f1egmatik/aircontrol/kicad/aircontrol.sch

## KiCad design kicad/aircontrol.sch (2021-11-26)

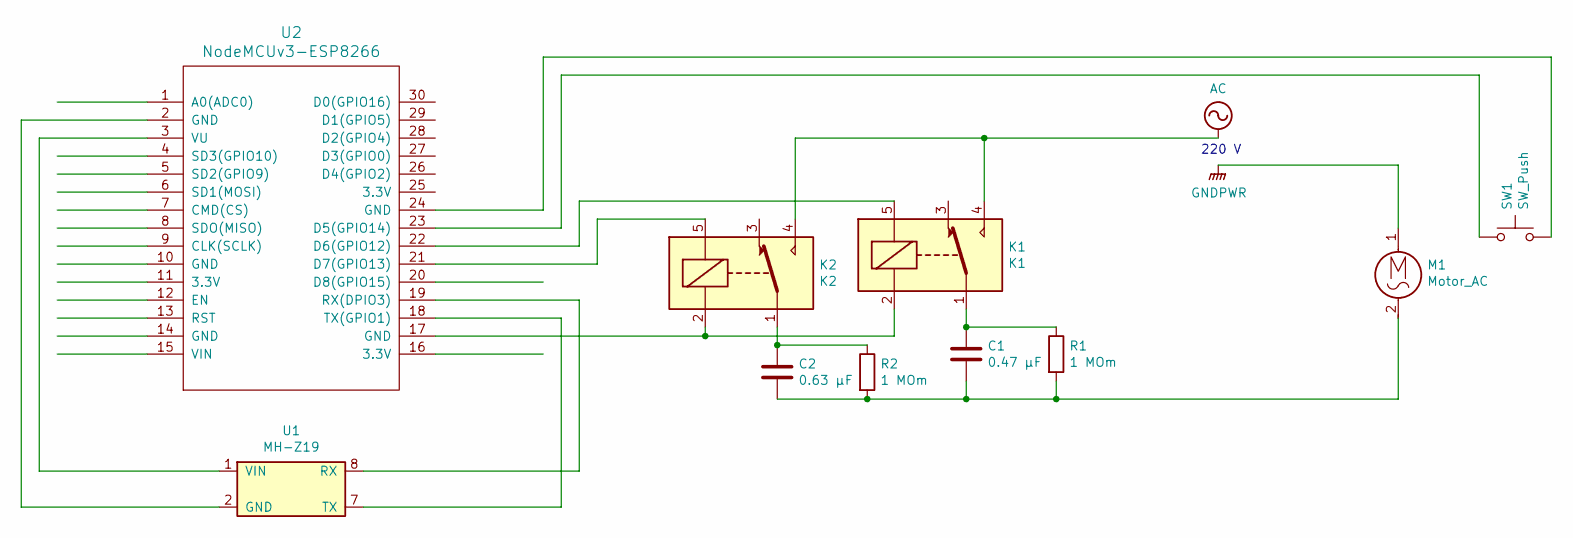
[picture p2: schematic aircontrol.sch]

Parts:
C1: 0.47 μF
C2: 0.63 μF
K1: K1; Relay_SPDT_SANYOU_SRD_Series_Form_C
K2: K2; Relay_SPDT_SANYOU_SRD_Series_Form_C
M1: Motor_AC
R1, R2: 1 MOm
SW1: SW_Push
U1: MH-Z19
U2: NodeMCUv3-ESP8266

Connections:
AC: K1.4, K2.4
GNDPWR: M1.1
unnamed: C1.1, K1.1, R1.1
unnamed: C1.2, C2.2, M1.2, R1.2, R2.2
unnamed: C2.1, K2.1, R2.1
unnamed: K1.2, K2.2, U2.17 (GND)
unnamed: K1.5, U2.22 (D6(GPIO12))
unnamed: K2.5, U2.21 (D7(GPIO13))
unnamed: SW1.1, U2.23 (D5(GPIO14))
unnamed: SW1.2, U2.24 (GND)
unnamed: U1.1 (VIN), U2.3 (VU)
unnamed: U1.2 (GND), U2.2 (GND)
unnamed: U1.7 (TX), U2.18 (TX(GPIO1))
unnamed: U1.8 (RX), U2.19 (RX(DPIO3))

Notes on the sheet:
220 V
