f1egmatik/aircontrol/(commit log)

2021-03-11 Update aircontrol.yaml
    Перенос кода из форка.
2021-03-11 Update dht_am2302.yaml
    Добавлена переменная `source_sensor_id`
2021-03-11 Update mhz19.yaml
    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
2021-03-13 Update aircontrol.yaml
    Инвертирована логика работы переключателя автоматического режима, добавлено авто включение при загрузке, а так же изменен его ID. Правка комментариев.
2021-03-13 Update aircontrol.yaml
    Исправлена ошибка логики.
    [aircontrol.yaml]
2021-03-13 Update dht_am2302.yaml
    Вход кнопки изменен на D6
2021-03-13 Update mhz19.yaml
    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
2021-03-13 Update aircontrol.yaml
    Добавлена возможность переключения вывода журнала на UART0_SWAP TX: GPIO15, RX: GPIO13 (только на ESP8266).
2021-03-13 D6 pin in schema
    [aircontrol.sch]
2021-03-14 Update dht_am2302.yaml
    Переназначены все контакты.
    (Контакты D3, D4 подтягиваются к "земле" при загрузке, что вызывало срабатывание реле.)
2021-03-14 Update mhz19.yaml
    Переназначены контакты реле и кнопки.
    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
2021-03-14 uart0 logger off
2021-03-14 Update aircontrol.yaml
    Исправлена логика переключателя Blow, теперь он дублирует функционал(но не состояние) аппаратного переключателя.
    [aircontrol.yaml]
2021-03-14 Update mhz19.yaml
    Удалены переменные.
2021-03-14 Update dht_am2302.yaml
    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
2021-03-14 Update aircontrol.yaml
    Исправлена логика
    [aircontrol.yaml]
2021-03-14 Update aircontrol.yaml
    Исправлена ошибка логики
    [aircontrol.yaml]
2021-03-14 Update aircontrol.yaml
    Исправлен датчик по умолчанию
    [aircontrol.yaml]
2021-03-14 Update mhz19.yaml
    Исправлены имена переменных
2021-03-14 Update dht_am2302.yaml
    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
2021-03-14 Update aircontrol.yaml
    Время продувки перемещено в переменные
2021-03-14 Update dht_am2302.yaml
    Добавлена переменная
2021-03-14 Update mhz19.yaml
    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
2021-03-15 Update hass_sensor.yaml
    Обновление комментариев
2021-03-15 Update aircontrol.yaml
    Добавлен конфиг `hass_sensor.yaml`
2021-03-31 Update aircontrol.yaml
    Логика автоматизации перенесена в скрипты. Исправлены условия.
    [aircontrol.yaml]
2021-03-31 Update dht_am2302.yaml
    Логика автоматизации перенесена в скрипты.
2021-03-31 Update hass_sensor.yaml
    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
2021-03-31 Update mhz19.yaml
    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
2021-04-16 Update mhz19.yaml
    Изменены порты GPIO
2021-04-16 Update dht_am2302.yaml
    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
2021-04-16 Update hass_sensor.yaml
    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
2021-11-26 mhz19.yaml-coded pins to kicad: mh-z19 to rx-tx, relays to gpio12-13, button to 14
    [aircontrol.sch]
2021-11-26 ошибки в тексте
2021-11-27 inverted in aircontrol / non-inverted in aircontrol2 outputs
    [aircontrol.yaml]
2025-10-31 Manual Switch Timeout
